frenchmatt/Music-LEDs/F2V LTSpice Simulation.asc

C1: cap; 100µ
C2: cap; 10µ
D1: diode; 1N914
Q1: pnp; 2N3906
R1: res; 140
R2: res; 1k
V2: voltage; 12
Vin: bv; V=sin(2*pi*(Fs+(Fe-Fs)/te*time/2)*time)
Named nets: 0, Vout
.tran 0 3 0 1
.param Fs 0
.param Fe 10000
.param te 3
